lfg-seth/OpenControlHead/firmware/button_controller/README.md

Havnig trouble opening this with PlatformIO? Try opening just this folder in VSCode and not the top level of the repo.
