lfg-seth/OpenControlHead/hardware/db10/DB10.step

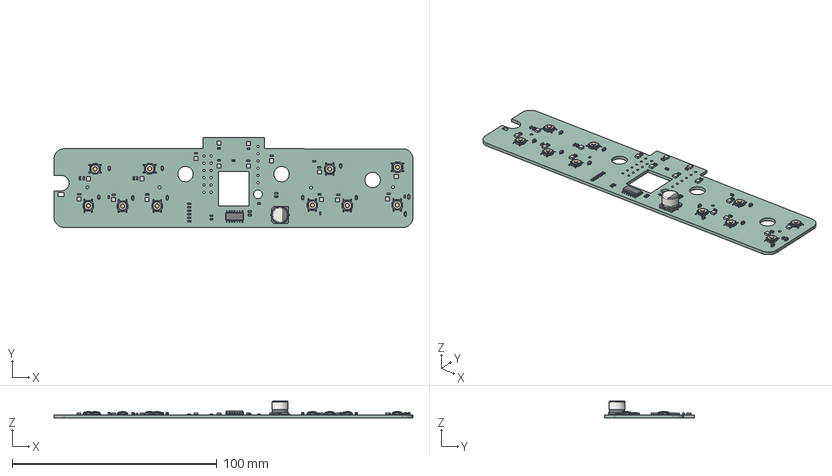
[picture p1: CAD file, 2025-11-08]
hardware/db10/DB10.step
175.5 x 44.0 x 8.29 mm
SW_SPST_TL3342 x 10
C_0603_1608Metric x 24
D_SOD-323 x 10
R_0603_1608Metric x 11
APA102-2020 x 16
CP_Elec_8x6.7
SOIC-14_3.9x8.7mm_P1.27mm
DB10_PCB
