lfg-seth/OpenControlHead/hardware/db38/APA102-2020.step

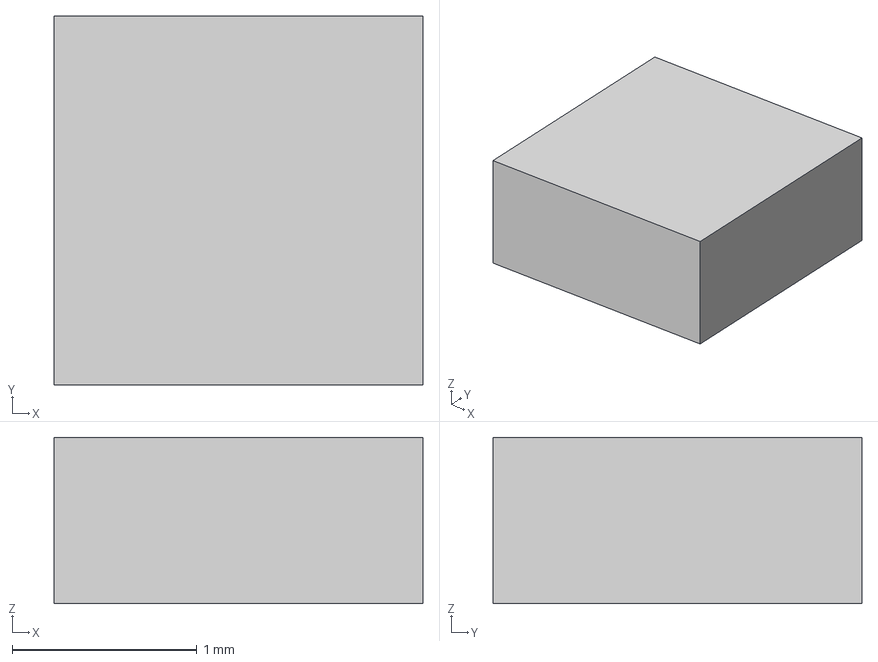
[picture p2: CAD file, 2025-11-08]
hardware/db38/APA102-2020.step
2.00 x 2.00 x 0.9 mm
