lfg-seth/OpenControlHead/hardware/db38/TCA8418/TCA8418RTWR.step

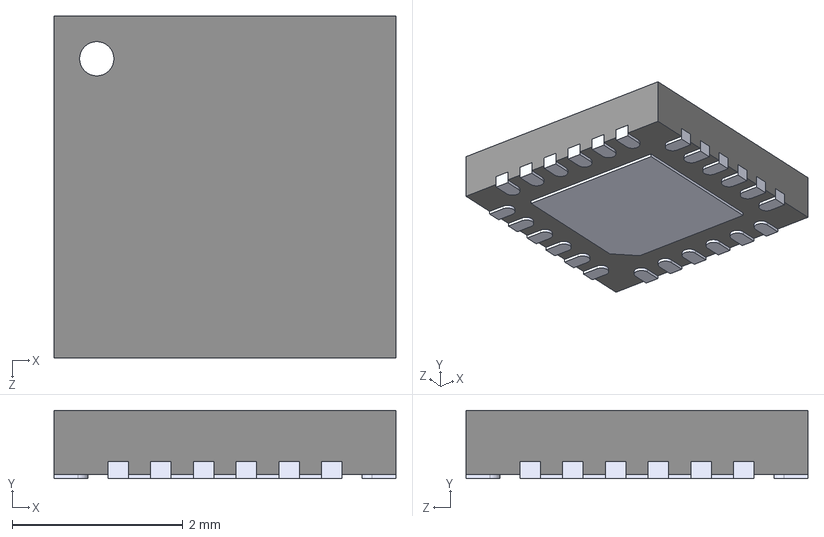
[picture p3: CAD file, 2025-11-08]
hardware/db38/TCA8418/TCA8418RTWR.step
4.00 x 0.8 x 4.00 mm
