lfg-seth/OpenControlHead/hardware/db10/Component9.step

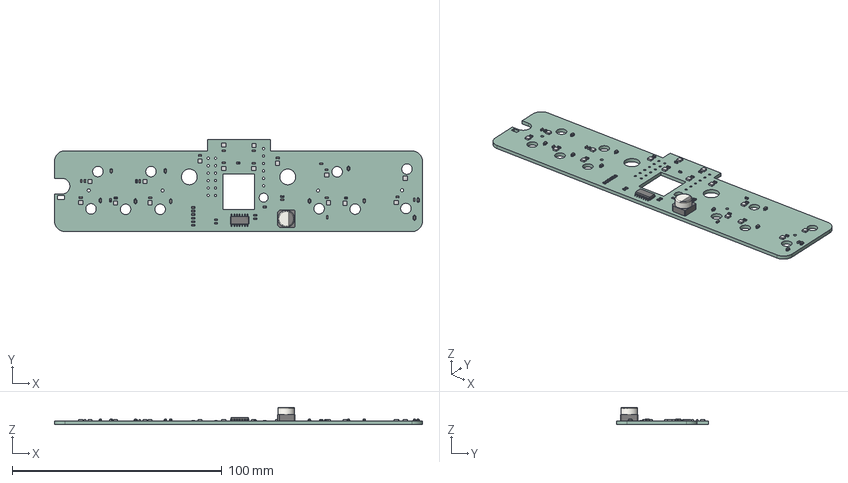
[picture p4: CAD file, 2025-11-08]
hardware/db10/Component9.step
175.5 x 44.0 x 8.29 mm
