lfg-seth/OpenControlHead/hardware/db10/DB10.kicad_pcb

## KiCad design hardware/db10/DB10.kicad_pcb (2025-11-08)

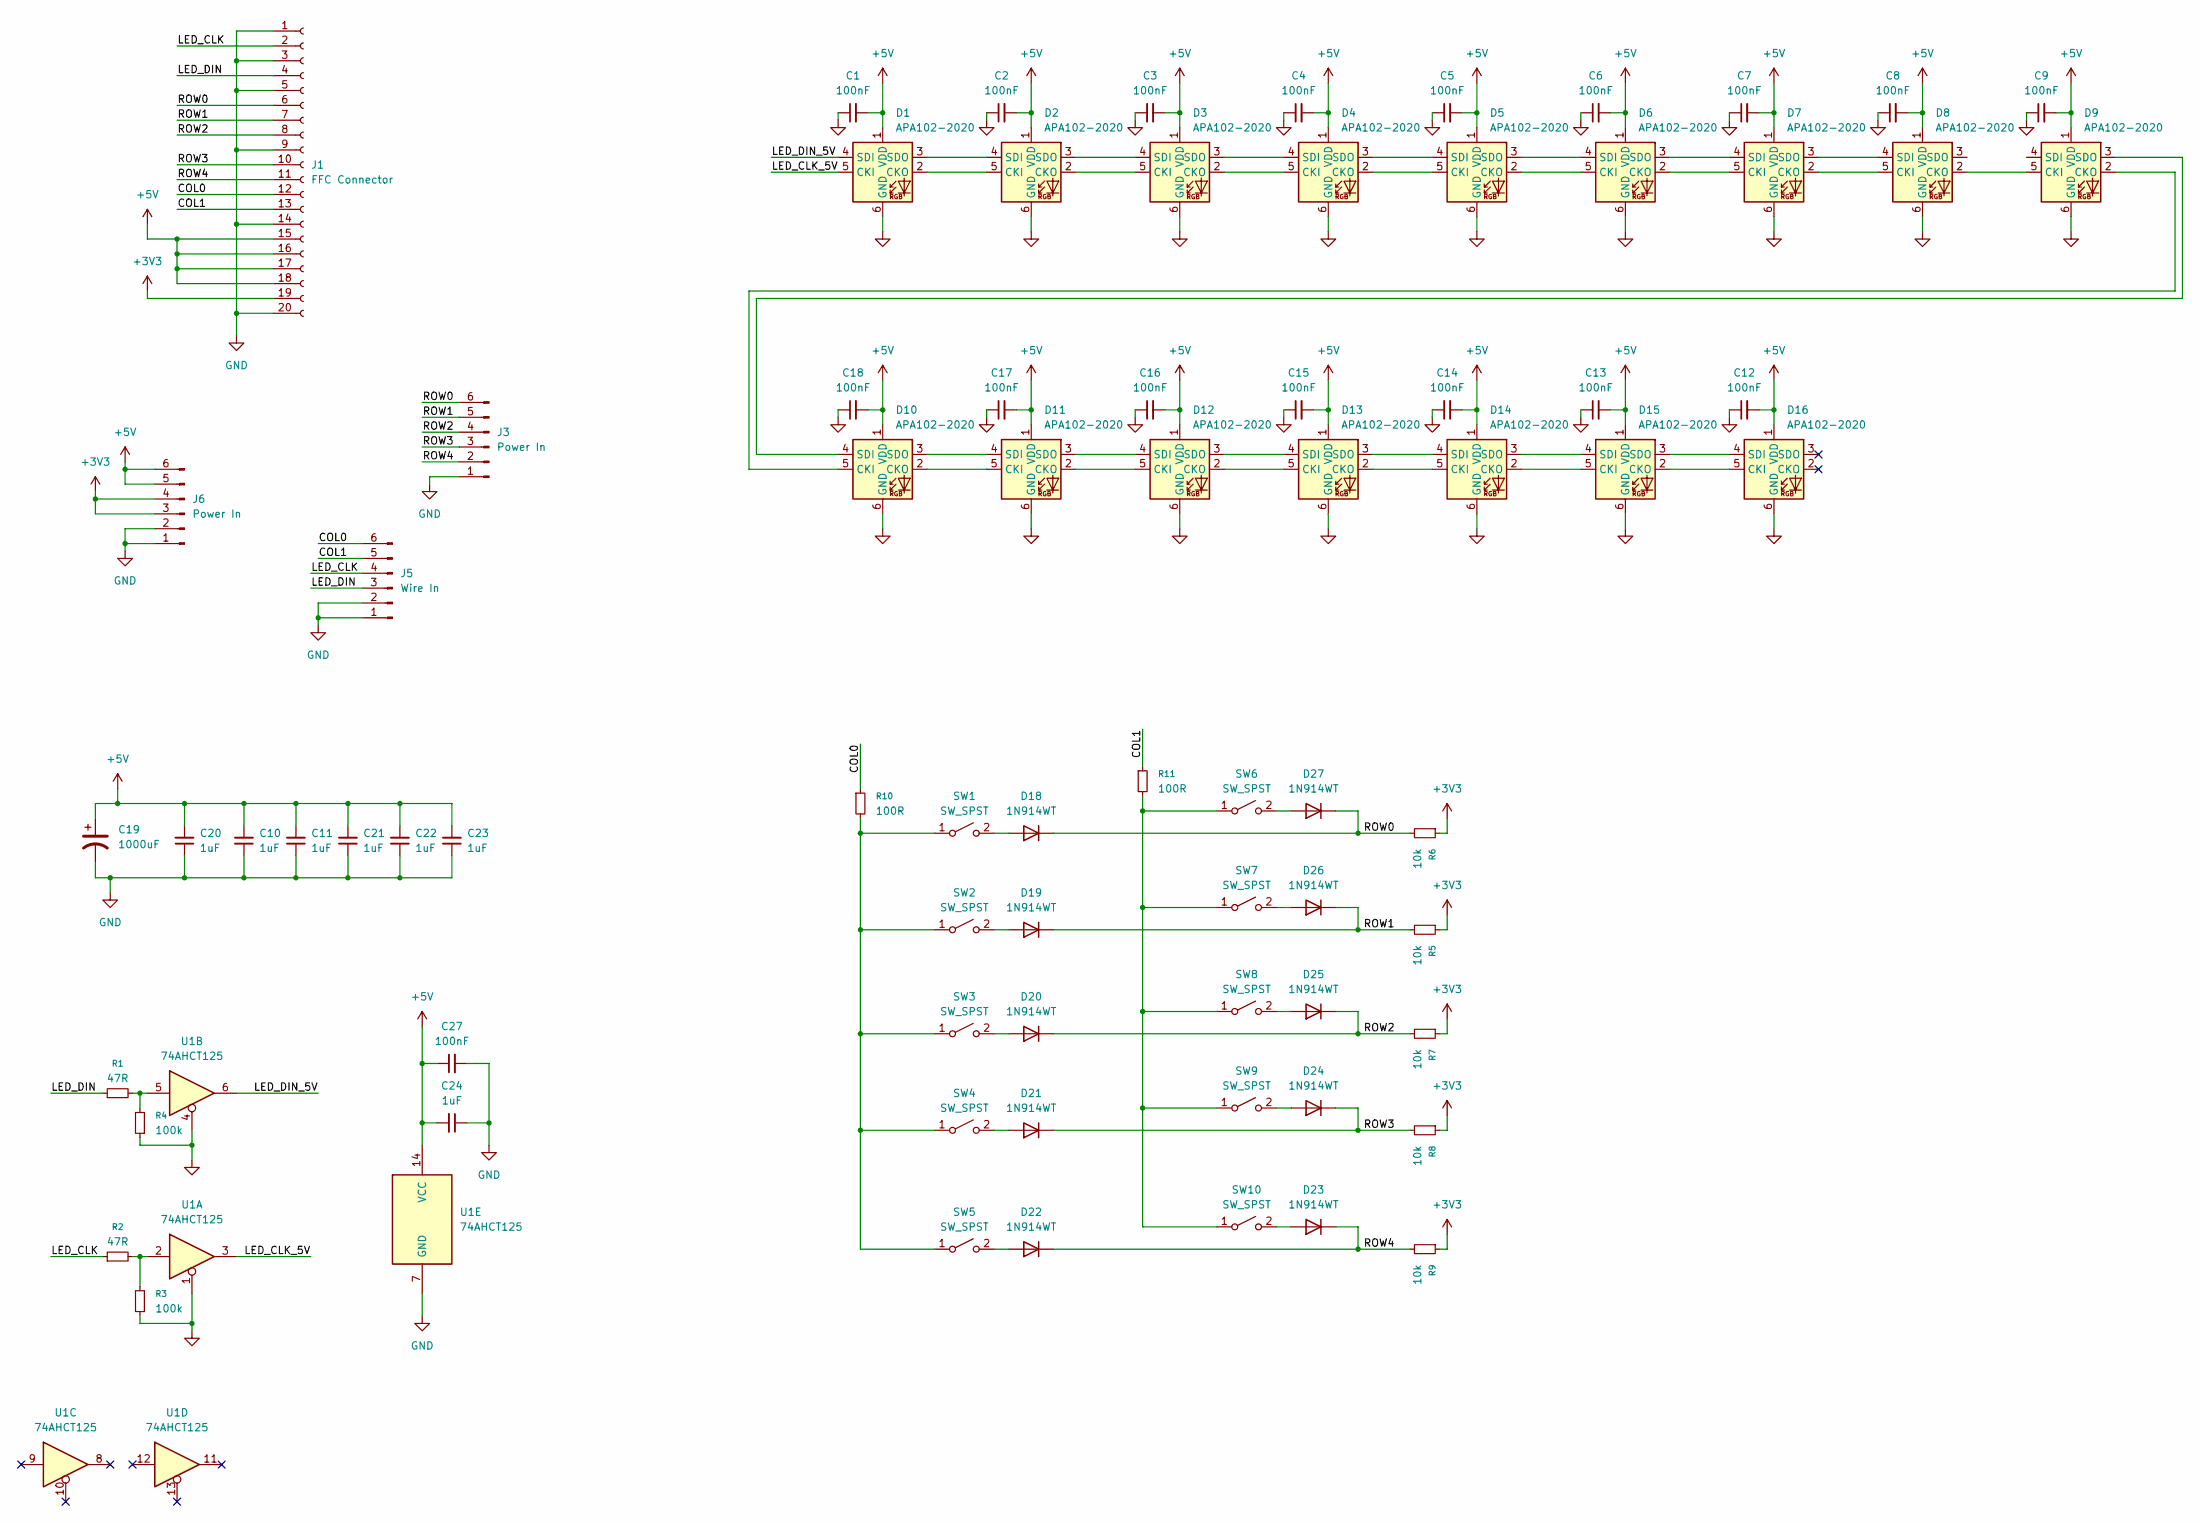
[picture p5: schematic DB10.kicad_sch, O9 Control Head - DB10]

Parts:
C1, C2, C3, C4, C5, C6, C7, C8, C9, C12, C13, C14, C15, C16, C17, C18, C27: 100nF; C_0603_1608Metric_Pad1.08x0.95mm_HandSolder
C10, C11, C20, C21, C22, C23, C24: 1uF; C_0603_1608Metric_Pad1.08x0.95mm_HandSolder
C19: 1000uF; CP_Elec_8x6.7
D1, D2, D3, D4, D5, D6, D7, D8, D9, D10, D11, D12, D13, D14, D15, D16: APA102-2020; LED-APA102-2020
D18, D19, D20, D21, D22, D23, D24, D25, D26, D27: 1N914WT; D_SOD-323_HandSoldering
J1: FFC Connector; Hirose_FH12-20S-0.5SH_1x20-1MP_P0.50mm_Horizontal
J3, J6: Power In; SolderWire-0.5sqmm_1x06_P4.8mm_D0.9mm_OD2.3mm
J5: Wire In; SolderWire-0.5sqmm_1x06_P4.8mm_D0.9mm_OD2.3mm
R1, R2: 47R; R_0603_1608Metric_Pad0.98x0.95mm_HandSolder
R3, R4: 100k; R_0603_1608Metric_Pad0.98x0.95mm_HandSolder
R5, R6, R7, R8, R9: 10k; R_0603_1608Metric_Pad0.98x0.95mm_HandSolder
R10, R11: 100R; R_0603_1608Metric_Pad0.98x0.95mm_HandSolder
SW1, SW2, SW3, SW4, SW5, SW6, SW7, SW8, SW9, SW10: SW_SPST; SW_SPST_TL3342
U1: 74AHCT125; SOIC-14_3.9x8.7mm_P1.27mm

Connections:
+3V3: J1.19, J6.3, J6.4, R5.1, R6.1, R7.1, R8.1, R9.1
+5V: C1.2, C2.2, C3.2, C4.2, C5.2, C6.2, C7.2, C8.2, C9.2, C10.2, C11.2, C12.2, C13.2, C14.2, C15.2, C16.2, C17.2, C18.2, C19.1, C20.2, C21.2, C22.2, C23.2, C24.2, C27.1, D1.1 (VDD), D2.1 (VDD), D3.1 (VDD), D4.1 (VDD), D5.1 (VDD), D6.1 (VDD), D7.1 (VDD), D8.1 (VDD), D9.1 (VDD), D10.1 (VDD), D11.1 (VDD), D12.1 (VDD), D13.1 (VDD), D14.1 (VDD), D15.1 (VDD), D16.1 (VDD), J1.15, J1.16, J1.17, J1.18, J6.5, J6.6, U1.14 (VCC)
/COL0: J1.12, J5.6, R10.1
/COL1: J1.13, J5.5, R11.1
/LED_CLK: J1.2, J5.4, R2.1
/LED_CLK_5V: D1.5 (CKI), U1.3
/LED_DIN: J1.4, J5.3, R1.1
/LED_DIN_5V: D1.4 (SDI), U1.6
/ROW0: D18.1 (K), D27.1 (K), J1.6, J3.6, R6.2
/ROW1: D19.1 (K), D26.1 (K), J1.7, J3.5, R5.2
/ROW2: D20.1 (K), D25.1 (K), J1.8, J3.4, R7.2
/ROW3: D21.1 (K), D24.1 (K), J1.10, J3.3, R8.2
/ROW4: D22.1 (K), D23.1 (K), J1.11, J3.2, R9.2
GND: C1.1, C2.1, C3.1, C4.1, C5.1, C6.1, C7.1, C8.1, C9.1, C10.1, C11.1, C12.1, C13.1, C14.1, C15.1, C16.1, C17.1, C18.1, C19.2, C20.1, C21.1, C22.1, C23.1, C24.1, C27.2, D1.6 (GND), D2.6 (GND), D3.6 (GND), D4.6 (GND), D5.6 (GND), D6.6 (GND), D7.6 (GND), D8.6 (GND), D9.6 (GND), D10.6 (GND), D11.6 (GND), D12.6 (GND), D13.6 (GND), D14.6 (GND), D15.6 (GND), D16.6 (GND), J1.1, J1.3, J1.5, J1.9, J1.14, J1.20, J3.1, J5.1, J5.2, J6.1, J6.2, R3.1, R4.1, U1.1, U1.4, U1.7 (GND)
unnamed: D1.2 (CKO), D2.5 (CKI)
unnamed: D1.3 (SDO), D2.4 (SDI)
unnamed: D2.2 (CKO), D3.5 (CKI)
unnamed: D2.3 (SDO), D3.4 (SDI)
unnamed: D3.2 (CKO), D4.5 (CKI)
unnamed: D3.3 (SDO), D4.4 (SDI)
unnamed: D4.2 (CKO), D5.5 (CKI)
unnamed: D4.3 (SDO), D5.4 (SDI)
unnamed: D5.2 (CKO), D6.5 (CKI)
unnamed: D5.3 (SDO), D6.4 (SDI)
unnamed: D6.2 (CKO), D7.5 (CKI)
unnamed: D6.3 (SDO), D7.4 (SDI)
unnamed: D7.2 (CKO), D8.5 (CKI)
unnamed: D7.3 (SDO), D8.4 (SDI)
unnamed: D8.2 (CKO), D9.5 (CKI)
unnamed: D9.2 (CKO), D10.5 (CKI)
unnamed: D10.2 (CKO), D11.5 (CKI)
unnamed: D9.3 (SDO), D10.4 (SDI)
unnamed: D10.3 (SDO), D11.4 (SDI)
unnamed: D11.2 (CKO), D12.5 (CKI)
unnamed: D11.3 (SDO), D12.4 (SDI)
unnamed: D12.2 (CKO), D13.5 (CKI)
unnamed: D12.3 (SDO), D13.4 (SDI)
unnamed: D13.2 (CKO), D14.5 (CKI)
unnamed: D13.3 (SDO), D14.4 (SDI)
unnamed: D14.2 (CKO), D15.5 (CKI)
unnamed: D14.3 (SDO), D15.4 (SDI)
unnamed: D15.2 (CKO), D16.5 (CKI)
unnamed: D15.3 (SDO), D16.4 (SDI)
unnamed: D18.2 (A), SW1.2 (B)
unnamed: D19.2 (A), SW2.2 (B)
unnamed: D20.2 (A), SW3.2 (B)
unnamed: D21.2 (A), SW4.2 (B)
unnamed: D22.2 (A), SW5.2 (B)
unnamed: D23.2 (A), SW10.2 (B)
unnamed: D24.2 (A), SW9.2 (B)
unnamed: D25.2 (A), SW8.2 (B)
unnamed: D26.2 (A), SW7.2 (B)
unnamed: D27.2 (A), SW6.2 (B)
unnamed: R1.2, R4.2, U1.5
unnamed: R2.2, R3.2, U1.2
unnamed: R10.2, SW1.1 (A), SW2.1 (A), SW3.1 (A), SW4.1 (A), SW5.1 (A)
unnamed: R11.2, SW6.1 (A), SW7.1 (A), SW8.1 (A), SW9.1 (A), SW10.1 (A)

Board: 2 copper layers, 76 parts (0 on the bottom side), 57 nets, no tracks yet.
