lfg-seth/OpenControlHead/apps/ui/resources_rc.py

# Resource object code (Python 3)
# Created by: object code
# Created by: The Resource Compiler for Qt version 6.10.0
# WARNING! All changes made in this file will be lost!

from PySide6 import QtCore

qt_resource_data = b"\
\x00\x00\x95%\
<\
?xml version=\x221.\
0\x22 encoding=\x22UTF\
-8\x22?>\x0a<svg id=\x22L\
ayer_1\x22 data-nam\
e=\x22Layer 1\x22 xmln\
s=\x22http://www.w3\
.org/2000/svg\x22 x\
mlns:xlink=\x22http\
://www.w3.org/19\
99/xlink\x22 viewBo\
x=\x220 0 162.62 36\
4.74\x22>\x0a  <defs>\x0a\
    <style>\x0a    \
  .cls-1 {\x0a     \
   stroke: #dfdf\
df;\x0a        stro\
ke-linecap: roun\
d;\x0a        strok\
e-linejoin: roun\
d;\x0a        strok\
e-width: .71px;\x0a\
      }\x0a\x0a      .\
cls-1, .cls-2 {\x0a\
        fill: no\
ne;\x0a      }\x0a\x0a   \
   .cls-3 {\x0a    \
    clip-path: u\
rl(#clippath-1);\
\x0a      }\x0a\x0a      \
.cls-4 {\x0a       \
 isolation: isol\
ate;\x0a      }\x0a\x0a  \
    .cls-5 {\x0a   \
     clip-path: \
url(#clippath);\x0a\
      }\x0a    </st\
yle>\x0a    <clipPa\
th id=\x22clippath\x22\
>\x0a      <rect cl\
ass=\x22cls-2\x22 widt\
h=\x22162.62\x22 heigh\
t=\x22364.74\x22/>\x0a   \
 </clipPath>\x0a   \
 <clipPath id=\x22c\
lippath-1\x22>\x0a    \
  <rect class=\x22c\
ls-2\x22 x=\x22-.38\x22 w\
idth=\x22163\x22 heigh\
t=\x22365\x22/>\x0a    </\
clipPath>\x0a  </de\
fs>\x0a  <g class=\x22\
cls-4\x22>\x0a    <g c\
lass=\x22cls-5\x22>\x0a  \
    <g class=\x22cl\
s-3\x22>\x0a        <p\
ath class=\x22cls-1\
\x22 d=\x22M122.29,9.2\
8c4.31,2.23,8.45\
,4.76,12.4,7.56,\
4.66,3.32,9.06,7\
,13.14,11.01.97.\
95,1.24,2.41.69,\
3.64-.71,1.57-1.\
42,3.14-2.12,4.7\
1-.12.28-.37.49-\
.67.57-.43.12-.8\
8.21-1.32.26-.84\
.09-1.7.11-2.54.\
06-.43-.02-.82-.\
25-1.05-.61-1.2-\
1.83-2.45-3.62-3\
.75-5.39-1.88-2.\
54-4.03-4.87-6.4\
3-6.93-3.87-3.33\
-7.91-6.47-12.09\
-9.4-1.66-1.16-3\
.34-2.3-5.03-3.4\
1-.47-.31-.92-.6\
5-1.35-1.03-.02-\
.02-.04-.04-.06-\
.06-.25-.29-.23-\
.72.06-.98.22-.2\
.49-.34.79-.4.55\
-.12,1.12-.21,1.\
69-.24,2.23-.13,\
4.48-.04,6.69.27\
.34.05.67.17.96.\
36\x22/>\x0a        <p\
ath class=\x22cls-1\
\x22 d=\x22M81.31,5.69\
h5.73c6.17,0,12.\
34.09,18.5.27,2.\
88.08,5.76-.14,8\
.59-.68,2.61-.5,\
5.21-1.06,7.8-1.\
68.21-.05.43-.02\
.61.1.69.45,1.28\
,1.04,1.72,1.73,\
1.43,2.23,2.86,4\
.46,4.3,6.68\x22/>\x0a\
        <path cl\
ass=\x22cls-1\x22 d=\x22M\
81.31.35h10.15c8\
.11,0,16.21.34,2\
4.29,1.02,2.22.1\
8,4.35.95,6.19,2\
.22\x22/>\x0a        <\
path class=\x22cls-\
1\x22 d=\x22M146.41,26\
.48l.15-.27c.12-\
.23.08-.51-.12-.\
69-2.01-1.83-3.9\
9-3.7-5.94-5.61-\
.65-.63-1.16-1.3\
8-1.54-2.21-.06-\
.14-.19-.23-.34-\
.26l-1.99-.12c-.\
26-.01-.51-.09-.\
74-.22-2.2-1.72-\
4.52-3.28-6.96-4\
.65-.15-.08-.28-\
.19-.38-.33\x22/>\x0a \
       <path cla\
ss=\x22cls-1\x22 d=\x22M1\
48.52,31.5c2.39,\
2.88,4,6.33,4.64\
,10.02.61,3.46.9\
2,6.96.94,10.47.\
07,13.28.07,26.5\
7.02,39.85,0,1.9\
-.18,3.8-.53,5.6\
7-.3,1.62-.96,3.\
16-1.93,4.5\x22/>\x0a \
       <path cla\
ss=\x22cls-1\x22 d=\x22M1\
41.14,118.12l-7.\
04,18.86c-.46,1.\
25-.86,2.52-1.19\
,3.81-.61,2.43-1\
.04,4.91-1.27,7.\
4-.58,6.24-.88,1\
2.51-.88,18.78,0\
,26.02-.09,52.05\
-.27,78.08,0,1.4\
2.04,2.85.13,4.2\
6.14,2.1.84,4.12\
,2.02,5.87,2.8,4\
.11,5.83,8.05,9.\
09,11.8,1.04,1.2\
,2.35,2.15,3.82,\
2.77,1.27.54,2.6\
2.86,3.99.95,1.4\
5.12,2.91.16,4.3\
7.14\x22/>\x0a        \
<path class=\x22cls\
-1\x22 d=\x22M145.96,1\
18.22c2.31.47,4.\
57,1.18,6.72,2.1\
3,1.5.66,2.9,1.5\
2,4.17,2.56.94.7\
7,1.81,1.62,2.61\
,2.54,1.01,1.17,\
1.82,2.49,2.4,3.\
93.39.96.5,2,.33\
,3.02-.01.08-.08\
.13-.16.12l-16.9\
8-3.26c-.2-.04-.\
36-.2-.39-.4-.09\
-.5-.12-1-.11-1.\
51.05-2.16.22-4.\
32.51-6.47.12-.8\
4.31-1.66.57-2.4\
6.04-.14.18-.22.\
32-.19\x22/>\x0a      \
  <path class=\x22c\
ls-1\x22 d=\x22M144.61\
,125.75l-1.94-.4\
c-.21-.04-.36-.2\
1-.39-.42v-7.27s\
0-.04,0-.07c.04-\
.2.23-.34.43-.3,\
1.05.19,2.07.52,\
3.04.97\x22/>\x0a     \
   <path class=\x22\
cls-1\x22 d=\x22M144.6\
2,125.52l6.5,2.2\
9c3.75,1.32,7.46\
,2.77,11.11,4.35\
\x22/>\x0a        <lin\
e class=\x22cls-1\x22 \
x1=\x22144.54\x22 y1=\x22\
127.52\x22 x2=\x22161.\
07\x22 y2=\x22131.66\x22/\
>\x0a        <line \
class=\x22cls-1\x22 x1\
=\x22137.7\x22 y1=\x22127\
.36\x22 x2=\x22144.6\x22 \
y2=\x22125.86\x22/>\x0a  \
      <path clas\
s=\x22cls-1\x22 d=\x22M13\
5.54,355.5l10.49\
-4.91c.83-.39,1.\
41-1.18,1.52-2.0\
9.8-6.16,1.54-12\
.33,2.25-18.5.38\
-3.29.79-6.58,1.\
24-9.86.15-1.07.\
32-2.14.53-3.21.\
19-.99.31-1.98.3\
6-2.99.15-17.86.\
17-35.73.08-53.5\
9\x22/>\x0a        <pa\
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
-20.81-2.6-31.13\
-4.38\x22/>\x0a       \
 <path class=\x22cl\
s-1\x22 d=\x22M81.31,3\
61.29h-34.02c-1.\
36,0-2.73-.14-4.\
07-.43-1.72-.37-\
3.41-.84-5.08-1.\
4-1.34-.45-2.16-\
1.79-1.98-3.18\x22/\
>\x0a        <path \
class=\x22cls-1\x22 d=\
\x22M28.5,352.19l21\
.28,2.31c1.53.17\
,3.05.39,4.56.65\
.97.17,1.85.68,2\
.47,1.44.18.21.2\
9.48.32.77.05.57\
.39,1.07.89,1.35\
.61.34,1.27.57,1\
.95.7\x22/>\x0a       \
 <line class=\x22cl\
s-1\x22 x1=\x2253.37\x22 \
y1=\x22354.99\x22 x2=\x22\
39.78\x22 y2=\x22354.9\
9\x22/>\x0a        <pa\
th class=\x22cls-1\x22\
 d=\x22M81.31,359.6\
4c-2.88,0-5.22-.\
5-5.22-1.11s2.34\
-1.11,5.22-1.11\x22\
/>\x0a      </g>\x0a  \
  </g>\x0a  </g>\x0a</\
svg>\
"

qt_resource_name = b"\
\x00\x06\
\x06\x8a\x9c\xb3\
\x00a\
\x00s\x00s\x00e\x00t\x00s\
\x00\x0e\
\x03\xbf\xcc\x87\
\x004\
\x00r\x00u\x00n\x00n\x00e\x00r\x00-\x000\x002\x00.\x00s\x00v\x00g\
"

qt_resource_struct = b"\
\x00\x00\x00\x00\x00\x02\x00\x00\x00\x01\x00\x00\x00\x01\
\x00\x00\x00\x00\x00\x00\x00\x00\
\x00\x00\x00\x00\x00\x02\x00\x00\x00\x01\x00\x00\x00\x02\
\x00\x00\x00\x00\x00\x00\x00\x00\
\x00\x00\x00\x12\x00\x00\x00\x00\x00\x01\x00\x00\x00\x00\
\x00\x00\x01\x9ae\xf58\x17\
"

def qInitResources():
    QtCore.qRegisterResourceData(0x03, qt_resource_struct, qt_resource_name, qt_resource_data)

def qCleanupResources():
    QtCore.qUnregisterResourceData(0x03, qt_resource_struct, qt_resource_name, qt_resource_data)

qInitResources()
