lfg-seth/OpenControlHead/apps/ui/src/resources_rc.py

# Resource object code (Python 3)
# Created by: object code
# Created by: The Resource Compiler for Qt version 6.10.0
# WARNING! All changes made in this file will be lost!

from PySide6 import QtCore

qt_resource_data = b"\
\x00\x00\x94\xeb\
<\
?xml version=\x221.\
0\x22 encoding=\x22UTF\
-8\x22?>\x0a<svg id=\x22L\
ayer_1\x22 data-nam\
e=\x22Layer 1\x22 xmln\
s=\x22http://www.w3\
.org/2000/svg\x22 x\
mlns:xlink=\x22http\
://www.w3.org/19\
99/xlink\x22 viewBo\
x=\x220 0 364.74 16\
2.62\x22>\x0a  <defs>\x0a\
    <style>\x0a    \
  .cls-1 {\x0a     \
   stroke: #cbcb\
cbff;\x0a        st\
roke-linecap: ro\
und;\x0a        str\
oke-linejoin: ro\
und;\x0a        str\
oke-width: .71px\
;\x0a      }\x0a\x0a     \
 .cls-1, .cls-2 \
{\x0a        fill: \
none;\x0a      }\x0a\x0a \
     .cls-3 {\x0a  \
      clip-path:\
 url(#clippath-1\
);\x0a      }\x0a\x0a    \
  .cls-4 {\x0a     \
   isolation: is\
olate;\x0a      }\x0a\x0a\
      .cls-5 {\x0a \
       clip-path\
: url(#clippath)\
;\x0a      }\x0a    </\
style>\x0a    <clip\
Path id=\x22clippat\
h\x22>\x0a      <rect \
class=\x22cls-2\x22 wi\
dth=\x22364.74\x22 hei\
ght=\x22162.62\x22/>\x0a \
   </clipPath>\x0a \
   <clipPath id=\
\x22clippath-1\x22>\x0a  \
    <rect class=\
\x22cls-2\x22 width=\x223\
65\x22 height=\x22163\x22\
/>\x0a    </clipPat\
h>\x0a  </defs>\x0a  <\
g class=\x22cls-4\x22>\
\x0a    <g class=\x22c\
ls-5\x22>\x0a      <g \
class=\x22cls-3\x22>\x0a \
       <path cla\
ss=\x22cls-1\x22 d=\x22M9\
.28,40.33c2.23-4\
.31,4.76-8.45,7.\
56-12.4,3.32-4.6\
6,7-9.06,11.01-1\
3.14.95-.97,2.41\
-1.24,3.64-.69,1\
.57.71,3.14,1.42\
,4.71,2.12.28.12\
.49.37.57.67.12.\
43.21.88.26,1.32\
.09.84.11,1.7.06\
,2.54-.02.43-.25\
.82-.61,1.05-1.8\
3,1.2-3.62,2.45-\
5.39,3.75-2.54,1\
.88-4.87,4.03-6.\
93,6.43-3.33,3.8\
7-6.47,7.91-9.4,\
12.09-1.16,1.66-\
2.3,3.34-3.41,5.\
03-.31.47-.65.92\
-1.03,1.35-.02.0\
2-.04.04-.06.06-\
.29.25-.72.23-.9\
8-.06-.2-.22-.34\
-.49-.4-.79-.12-\
.55-.21-1.12-.24\
-1.69-.13-2.23-.\
04-4.48.27-6.69.\
05-.34.17-.67.36\
-.96\x22/>\x0a        \
<path class=\x22cls\
-1\x22 d=\x22M5.69,81.\
31v-5.73c0-6.17.\
09-12.34.27-18.5\
.08-2.88-.14-5.7\
6-.68-8.59-.5-2.\
61-1.06-5.21-1.6\
8-7.8-.05-.21-.0\
2-.43.1-.61.45-.\
69,1.04-1.28,1.7\
3-1.72,2.23-1.43\
,4.46-2.86,6.68-\
4.3\x22/>\x0a        <\
path class=\x22cls-\
1\x22 d=\x22M.35,81.31\
v-10.15c0-8.11.3\
4-16.21,1.02-24.\
29.18-2.22.95-4.\
35,2.22-6.19\x22/>\x0a\
        <path cl\
ass=\x22cls-1\x22 d=\x22M\
26.48,16.21l-.27\
-.15c-.23-.12-.5\
1-.08-.69.12-1.8\
3,2.01-3.7,3.99-\
5.61,5.94-.63.65\
-1.38,1.16-2.21,\
1.54-.14.06-.23.\
19-.26.34l-.12,1\
.99c-.01.26-.09.\
51-.22.74-1.72,2\
.2-3.28,4.52-4.6\
5,6.96-.08.15-.1\
9.28-.33.38\x22/>\x0a \
       <path cla\
ss=\x22cls-1\x22 d=\x22M3\
1.5,14.1c2.88-2.\
39,6.33-4,10.02-\
4.64,3.46-.61,6.\
96-.92,10.47-.94\
,13.28-.07,26.57\
-.07,39.85-.02,1\
.9,0,3.8.18,5.67\
.53,1.62.3,3.16.\
96,4.5,1.93\x22/>\x0a \
       <path cla\
ss=\x22cls-1\x22 d=\x22M1\
18.12,21.48l18.8\
6,7.04c1.25.46,2\
.52.86,3.81,1.19\
,2.43.61,4.91,1.\
04,7.4,1.27,6.24\
.58,12.51.88,18.\
78.88,26.02,0,52\
.05.09,78.08.27,\
1.42,0,2.85-.04,\
4.26-.13,2.1-.14\
,4.12-.84,5.87-2\
.02,4.11-2.8,8.0\
5-5.83,11.8-9.09\
,1.2-1.04,2.15-2\
.35,2.77-3.82.54\
-1.27.86-2.62.95\
-3.99.12-1.45.16\
-2.91.14-4.37\x22/>\
\x0a        <path c\
lass=\x22cls-1\x22 d=\x22\
M118.22,16.66c.4\
7-2.31,1.18-4.57\
,2.13-6.72.66-1.\
5,1.52-2.9,2.56-\
4.17.77-.94,1.62\
-1.81,2.54-2.61,\
1.17-1.01,2.49-1\
.82,3.93-2.4.96-\
.39,2-.5,3.02-.3\
3.08.01.13.08.12\
.16l-3.26,16.98c\
-.04.2-.2.36-.4.\
39-.5.09-1,.12-1\
.51.11-2.16-.05-\
4.32-.22-6.47-.5\
1-.84-.12-1.66-.\
31-2.46-.57-.14-\
.04-.22-.18-.19-\
.32\x22/>\x0a        <\
path class=\x22cls-\
1\x22 d=\x22M125.75,18\
.02l-.4,1.94c-.0\
4.21-.21.36-.42.\
39h-7.27s-.04,0-\
.07,0c-.2-.04-.3\
4-.23-.3-.43.19-\
1.05.52-2.07.97-\
3.04\x22/>\x0a        \
<path class=\x22cls\
-1\x22 d=\x22M125.52,1\
8l2.29-6.5c1.32-\
3.75,2.77-7.46,4\
.35-11.11\x22/>\x0a   \
     <line class\
=\x22cls-1\x22 x1=\x22127\
.52\x22 y1=\x2218.08\x22 \
x2=\x22131.66\x22 y2=\x22\
1.55\x22/>\x0a        \
<line class=\x22cls\
-1\x22 x1=\x22127.36\x22 \
y1=\x2224.92\x22 x2=\x221\
25.86\x22 y2=\x2218.02\
\x22/>\x0a        <pat\
h class=\x22cls-1\x22 \
d=\x22M355.5,27.09l\
-4.91-10.49c-.39\
-.83-1.18-1.41-2\
.09-1.52-6.16-.8\
-12.33-1.54-18.5\
-2.25-3.29-.38-6\
.58-.79-9.86-1.2\
4-1.07-.15-2.14-\
.32-3.21-.53-.99\
-.19-1.98-.31-2.\
99-.36-17.86-.15\
-35.73-.17-53.59\
-.08\x22/>\x0a        \
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
h class=\x22cls-1\x22 \
d=\x22M361.29,81.31\
v34.02c0,1.36-.1\
4,2.73-.43,4.07-\
.37,1.72-.84,3.4\
1-1.4,5.08-.45,1\
.34-1.79,2.16-3.\
18,1.98\x22/>\x0a     \
   <path class=\x22\
cls-1\x22 d=\x22M352.1\
9,134.12l2.31-21\
.28c.17-1.53.39-\
3.05.65-4.56.17-\
.97.68-1.85,1.44\
-2.47.21-.18.48-\
.29.77-.32.57-.0\
5,1.07-.39,1.35-\
.89.34-.61.57-1.\
27.7-1.95\x22/>\x0a   \
     <line class\
=\x22cls-1\x22 x1=\x22354\
.99\x22 y1=\x22109.25\x22\
 x2=\x22354.99\x22 y2=\
\x22122.84\x22/>\x0a     \
   <path class=\x22\
cls-1\x22 d=\x22M359.6\
4,81.31c0,2.88-.\
5,5.22-1.11,5.22\
s-1.11-2.34-1.11\
-5.22\x22/>\x0a      <\
/g>\x0a    </g>\x0a  <\
/g>\x0a</svg>\
"

qt_resource_name = b"\
\x00\x06\
\x06\x8a\x9c\xb3\
\x00a\
\x00s\x00s\x00e\x00t\x00s\
\x00\x0e\
\x03\xbf\xcc\x87\
\x004\
\x00r\x00u\x00n\x00n\x00e\x00r\x00-\x000\x002\x00.\x00s\x00v\x00g\
"

qt_resource_struct = b"\
\x00\x00\x00\x00\x00\x02\x00\x00\x00\x01\x00\x00\x00\x01\
\x00\x00\x00\x00\x00\x00\x00\x00\
\x00\x00\x00\x00\x00\x02\x00\x00\x00\x01\x00\x00\x00\x02\
\x00\x00\x00\x00\x00\x00\x00\x00\
\x00\x00\x00\x12\x00\x00\x00\x00\x00\x01\x00\x00\x00\x00\
\x00\x00\x01\x9ae\x99\x8b\xb2\
"

def qInitResources():
    QtCore.qRegisterResourceData(0x03, qt_resource_struct, qt_resource_name, qt_resource_data)

def qCleanupResources():
    QtCore.qUnregisterResourceData(0x03, qt_resource_struct, qt_resource_name, qt_resource_data)

qInitResources()
