lfg-seth/OpenControlHead/apps/ui/src/logging_setup.py

# logging_setup.py
import logging
from logging.handlers import RotatingFileHandler

def setup_logging():
    logger = logging.getLogger("control_head")
    logger.setLevel(logging.DEBUG)

    fmt = logging.Formatter(
        "%(asctime)s [%(levelname)s] [%(origin)s] %(message)s",
        datefmt="%Y-%m-%d %H:%M:%S"
    )

    # Console
    ch = logging.StreamHandler()
    ch.setLevel(logging.DEBUG)
    ch.setFormatter(fmt)
    logger.addHandler(ch)

    # File (rotating)
    fh = RotatingFileHandler("control_head.log", maxBytes=1_000_000, backupCount=3)
    fh.setLevel(logging.DEBUG)
    fh.setFormatter(fmt)
    logger.addHandler(fh)

    return logger
