lfg-seth/OpenControlHead/(commit log)

2025-11-08 Add hardware
    [APA102-2020.step, Component9.step, DB10.kicad_pcb, DB10.kicad_sch, DB10.step, DB38.kicad_pcb, DB38.kicad_sch, TCA8418RTWR.step]
2025-11-08 Add pico firmware
2025-11-11 add switch controller scaffold
2025-11-11 Refactor PCM and Switch imports; enhance LogicalSwitch logging and functionality
2025-11-11 Enhance Bridge class with switch state management and toggle functionality
2025-11-11 Refactor hardware layer initialization in app.py to streamline switch registration and remove redundant code
2025-11-11 Refactor logging in QmlLogBridge and enhance button handling in Bridge class
2025-11-11 Update button mapping in Bridge class to use descriptive names
2025-11-14 Adjust image anchoring and size in LightsPage; add properties for front lights switch in app.py
2025-11-22 Add Flashers logical switch and update button mapping
2025-12-03 add pico firmware for pcm and switchpanel
